kfmut/oboroty_narabotka/BOM.csv

ID | Name | Designator | Footprint | Quantity | Manufacturer Part | Manufacturer | Supplier | Supplier Part | Price
1 | 0u1 / 50V | C1 | C1206 MM MILL_PADS | 1 | GRM319R71H104KA01J | Murata | Chip-i-Dip | 348319975
2 | 10u / 10V | C2 | CAP-SMD-TYPE-A MILL_PADS | 1 | SMD-A | NoName | Chip-i-Dip | 868717967
3 | 22p / 50V | C3,C4 | C1206 MM MILL_PADS | 2 | GRM3165C1H220JD01D | Murata | Chip-i-Dip | 189092684
4 | 1u / 50V | C5 | C1206 MM MILL_PADS | 1 | GRM31MR71H105KA88L | Murata | Chip-i-Dip | 9000062095
5 | 10n / 50V | C6 | C1206 MM MILL_PADS | 1 | GRM319R71H103KA01D | Murata | Chip-i-Dip | 296440765
6 | MW-4M | CON_I2C | MW-4(DS1066) MILL_PADS | 1 | DS1066-4MVW6X | Connfly | Chip-i-Dip | 9000325600
7 | CWF-2MR | CON_PWR | CWF-2RA(DS1069) MILL_PADS | 1 | DS1069-2MRW6SA | Connfly | Chip-i-Dip | 9000295851
8 | MBR0520L | D1 | SOD-123 MILL_PADS | 1 | MBR0520L | ON Semiconductor | Chip-i-Dip | 9000119271
9 | MF-MSMF014 / 140mA | F1 | F1812 MILL_PADS | 1 | MF-MSMF014 | Bourns | Chip-i-Dip | 457380901
10 | LED-3216 | LED_PW | D1206 MM MILL_PADS | 1 | LED-3216 | NoName | Chip-i-Dip | 9000414321
11 | 4k7 | R1,R2 | R1206 MM MILL_PADS | 2 | 1206 | NoName | Chip-i-Dip | 9000079651
12 | 6k2 | R3 | R1206 MM MILL_PADS | 1 | 1206 | NoName | Chip-i-Dip | 9000079654
13 | 180 | R4 | R1206 MM MILL_PADS | 1 | 1206 | NoName | Chip-i-Dip | 9000079897
14 | 2k2 | R5 | R1206 MM MILL_PADS | 1 | 1206 | NoName | Chip-i-Dip | 9000079643
15 | 1M | R6 | R1206 MM MILL_PADS | 1 | 1206 | NoName | Chip-i-Dip | 690816980
16 | PLS-2 | SW_DBG | PLS-2 (DS1021) MILL_PADS | 1 | DS1021-1*2SF11-B | Connfly | Chip-i-Dip | 260750144
17 | ATtiny85-20PU | U1 | DIP-8 MM MILL_PADS | 1 | ATtiny85-20PU | Atmel | Chip-i-Dip | 9000044997
18 | LP2985 | U2 | SOT-23-5 MM MILL_PADS | 1 | LP2985AIM5X-5.0/NOPB | Texas Instruments | Chip-i-Dip | 967040009
19 | TCST1103 | U3 | TCST1XXX MILL_PADS | 1 | TCST1103 | Vishay | Chip-i-Dip | 5327639455
20 | 16MHz | X1 | HC-49S MILL_PADS | 1 | HC-49S | NoName | Chip-i-Dip | 533649596
