kfmut/oboroty_narabotka/board_schematic.pdf

## GND

1 | GND

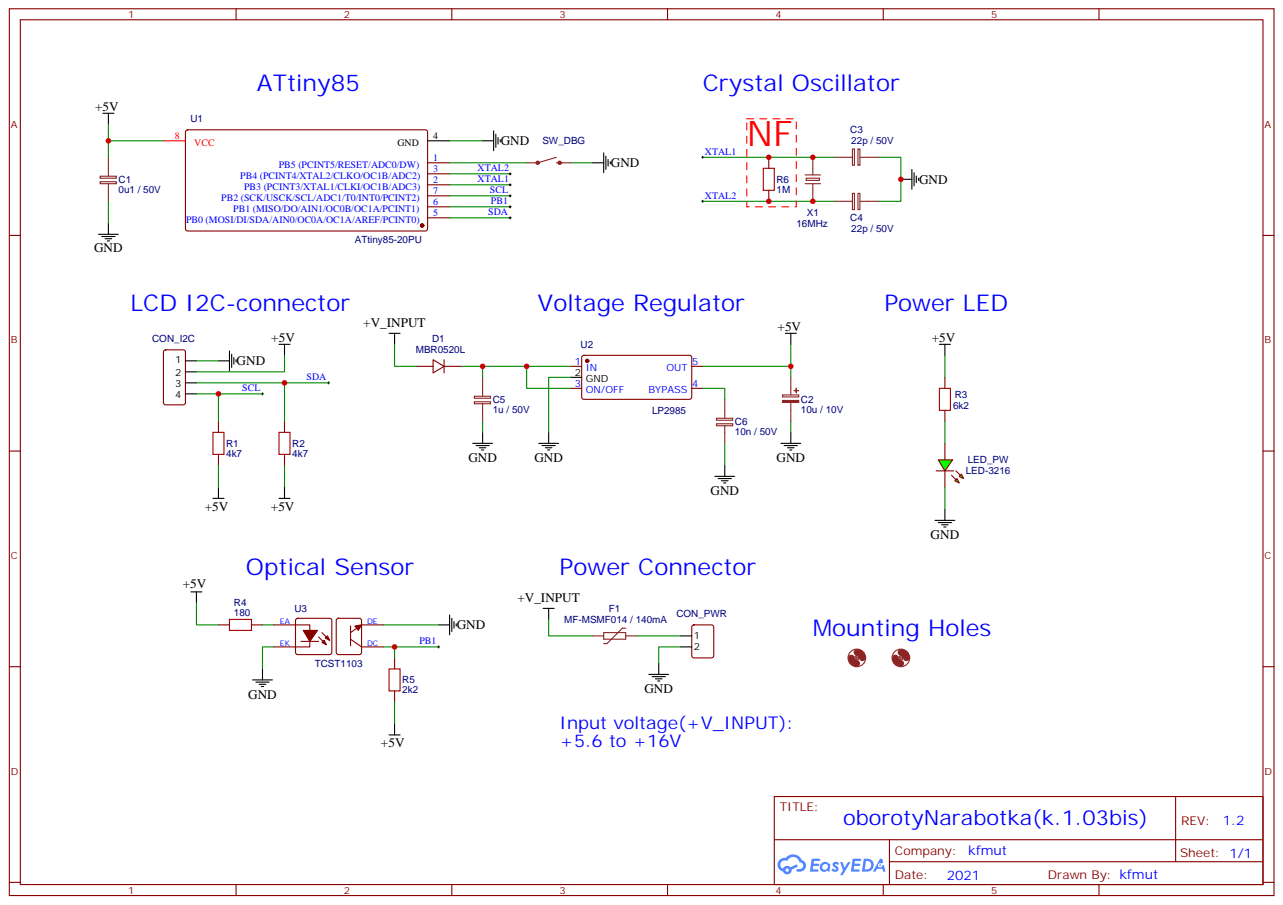
[picture p2: page 1]

PB0 (MOSI/DI/SDA/AIN0/OC0A/OC1A/AREF/PCINT0)
